pllagunos/espnow-kiln/hardware/controller/Sheet_1.png

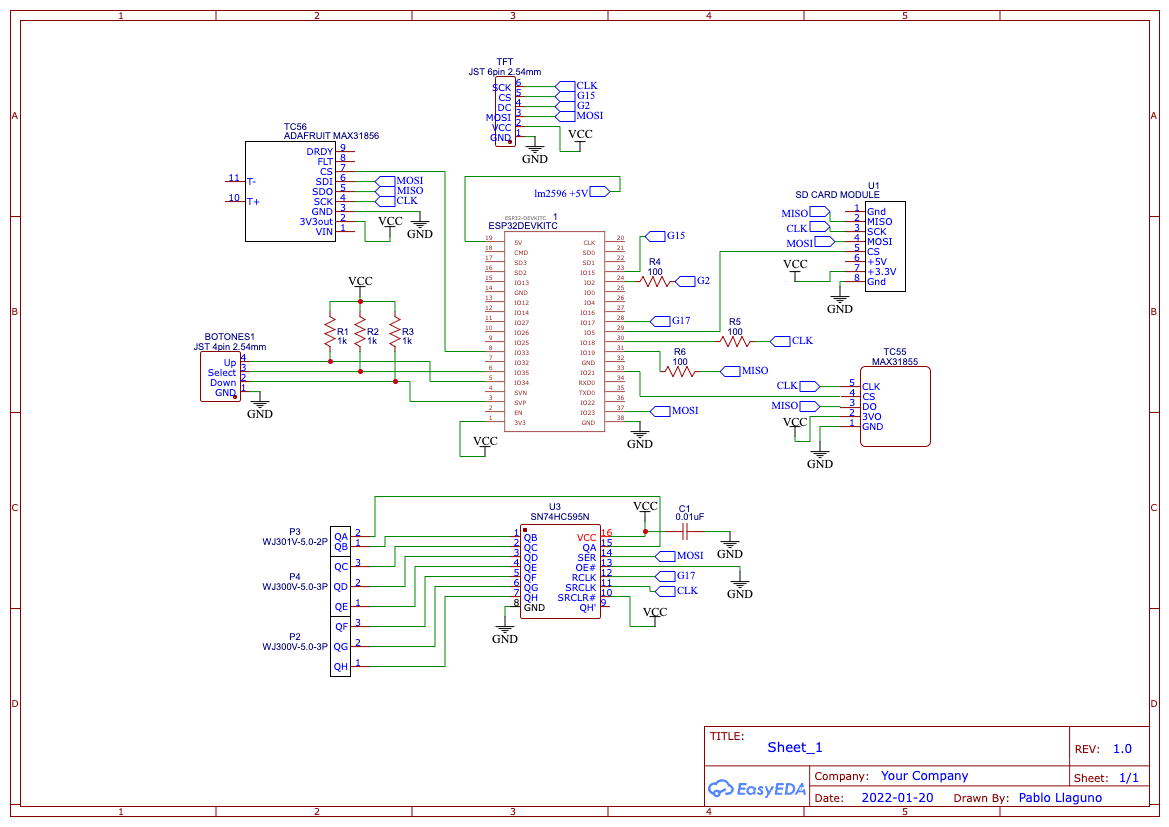
hardware/controller/Sheet_1.png
