pllagunos/espnow-kiln/hardware/controller/Sheet_2.png

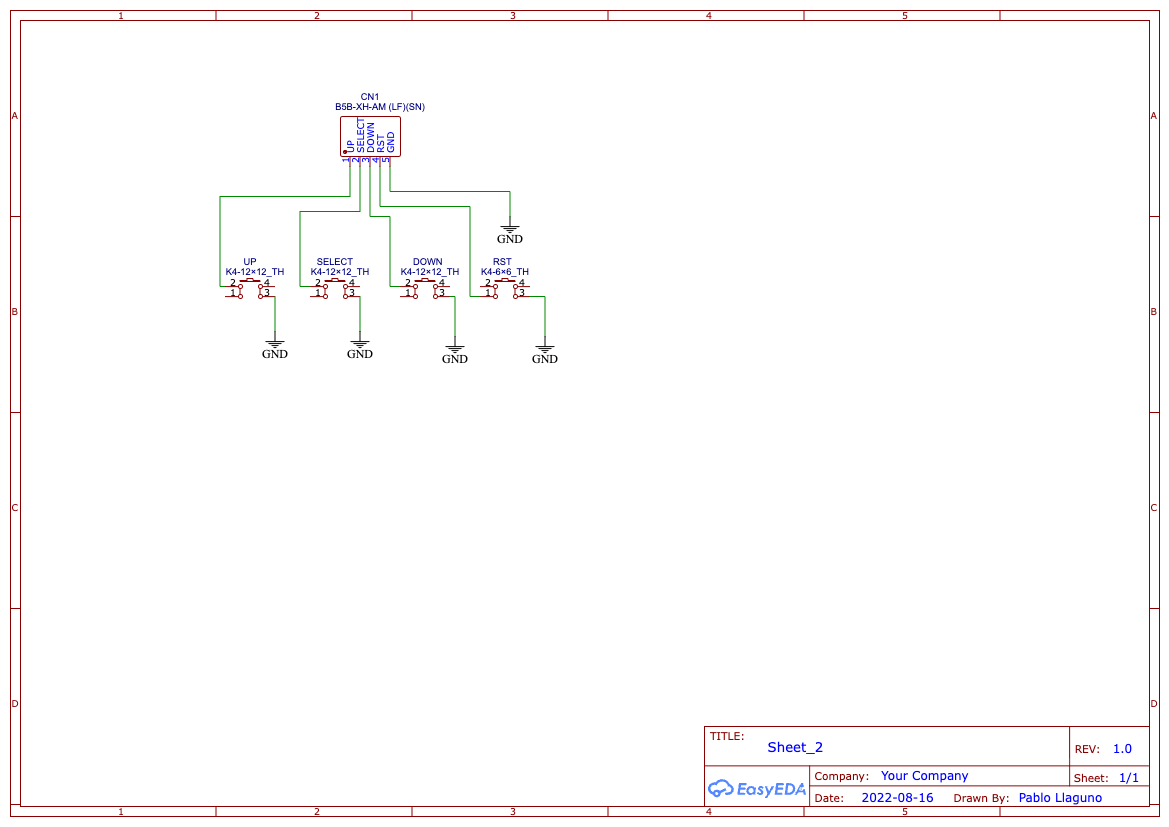
hardware/controller/Sheet_2.png
