pllagunos/espnow-kiln/hardware/espnow-nodes/Schematic_ESP32-DPT-station_2026-05-20.png

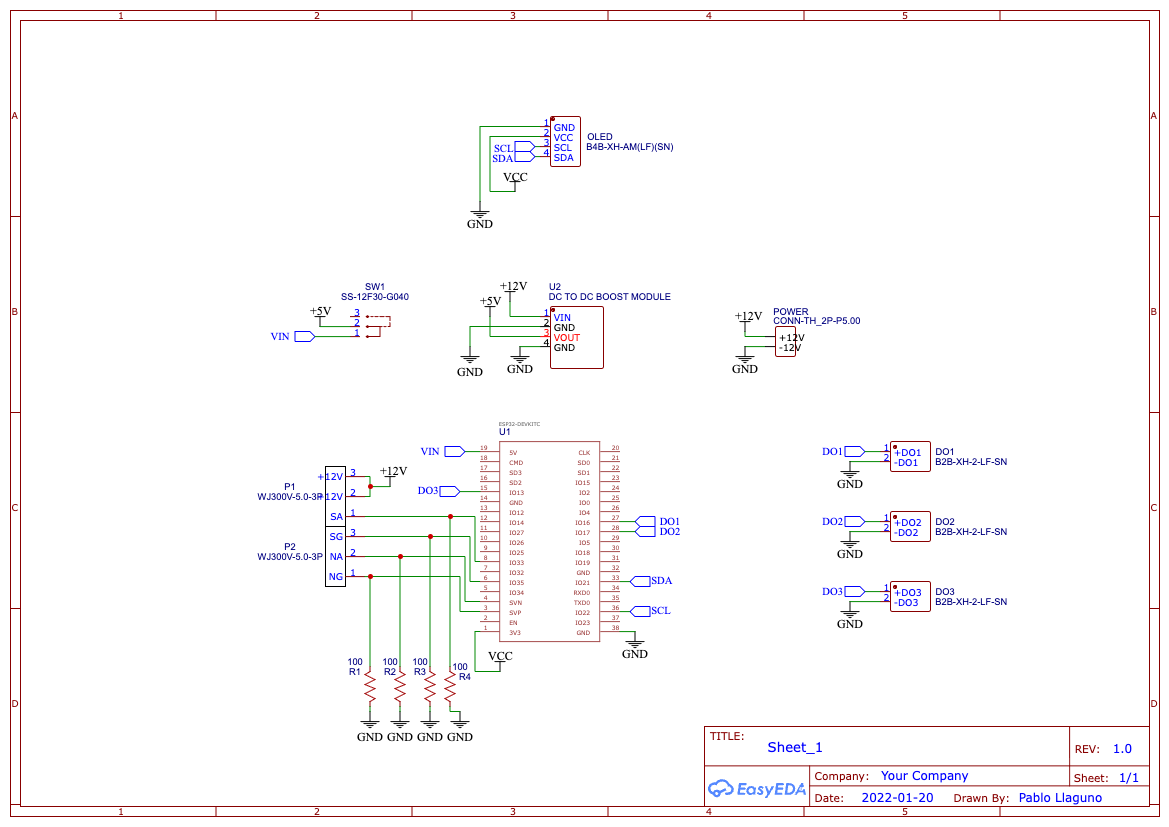
hardware/espnow-nodes/Schematic_ESP32-DPT-station_2026-05-20.png
