pllagunos/espnow-kiln/(list of files, drawings)

Other design files:
hardware/controller/SCH_ESP32-Furnace-Controller_2026-05-20.json
hardware/espnow-nodes/PCB_PCB_ESP32-DPT-station_2026-05-20.json
hardware/espnow-nodes/SCH_ESP32-DPT-station_2026-05-20.json
