pllagunos/espnow-kiln/(commit log)

2024-02-14 Soaking is now done with PID. fireOff now also deactivates PIDs
2024-02-20 volatile and espnow channel reconnect (not working properly)
    [main.ino]
2026-05-20 added hardware files and readme changes
    [PCB_PCB_ESP32-DPT-station_2026-05-20.json, SCH_ESP32-DPT-station_2026-05-20.json, SCH_ESP32-Furnace-Controller_2026-05-20.json]
